rbtsco/USB2CAN/Board/render1.png

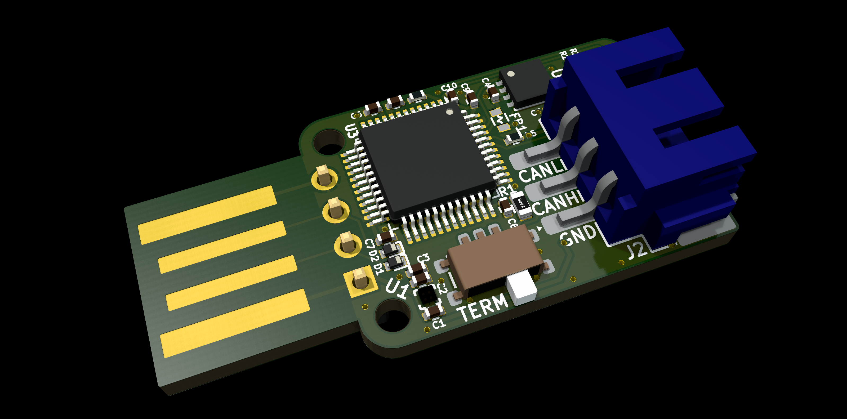
Board/render1.png
