rbtsco/USB2CAN/README.md

# USB2CAN
Tiny USB to 8Mbps Flexible-Data CAN (/ AUVCAN) adapter based on the STM32L5 and MCP2562FD
