rbtsco/USB2CAN/Board/CAM/Bottom.png

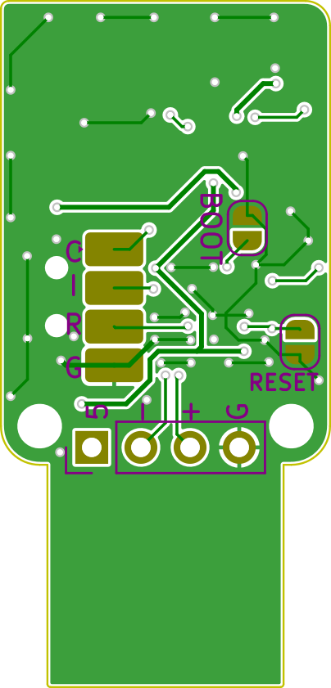
Board/CAM/Bottom.png
