rbtsco/USB2CAN/Board/CAM/Top.png

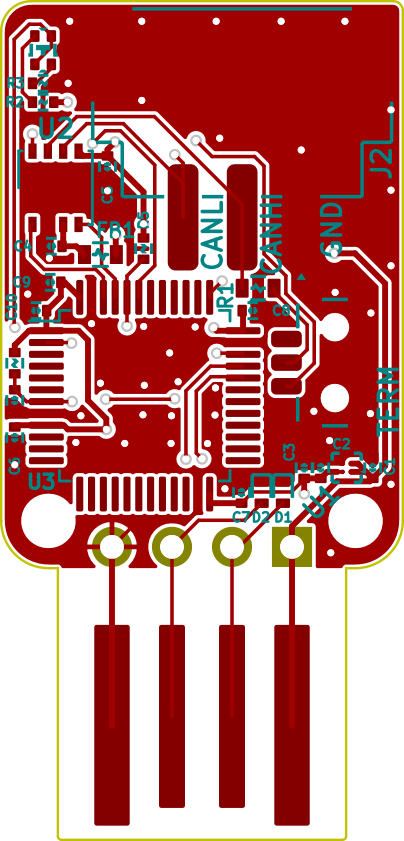
Board/CAM/Top.png
