rbtsco/USB2CAN/Board/render2.png

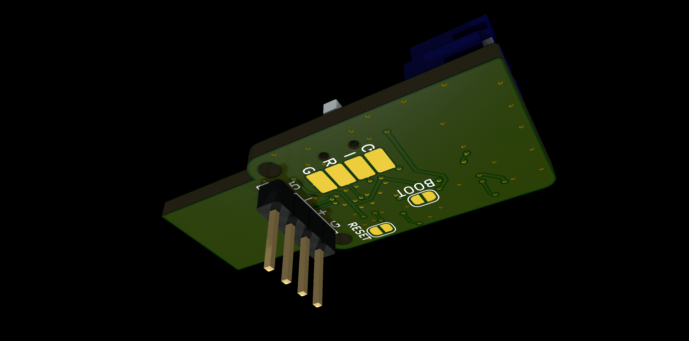
Board/render2.png
