rbtsco/USB2CAN/Board/Schematic.png

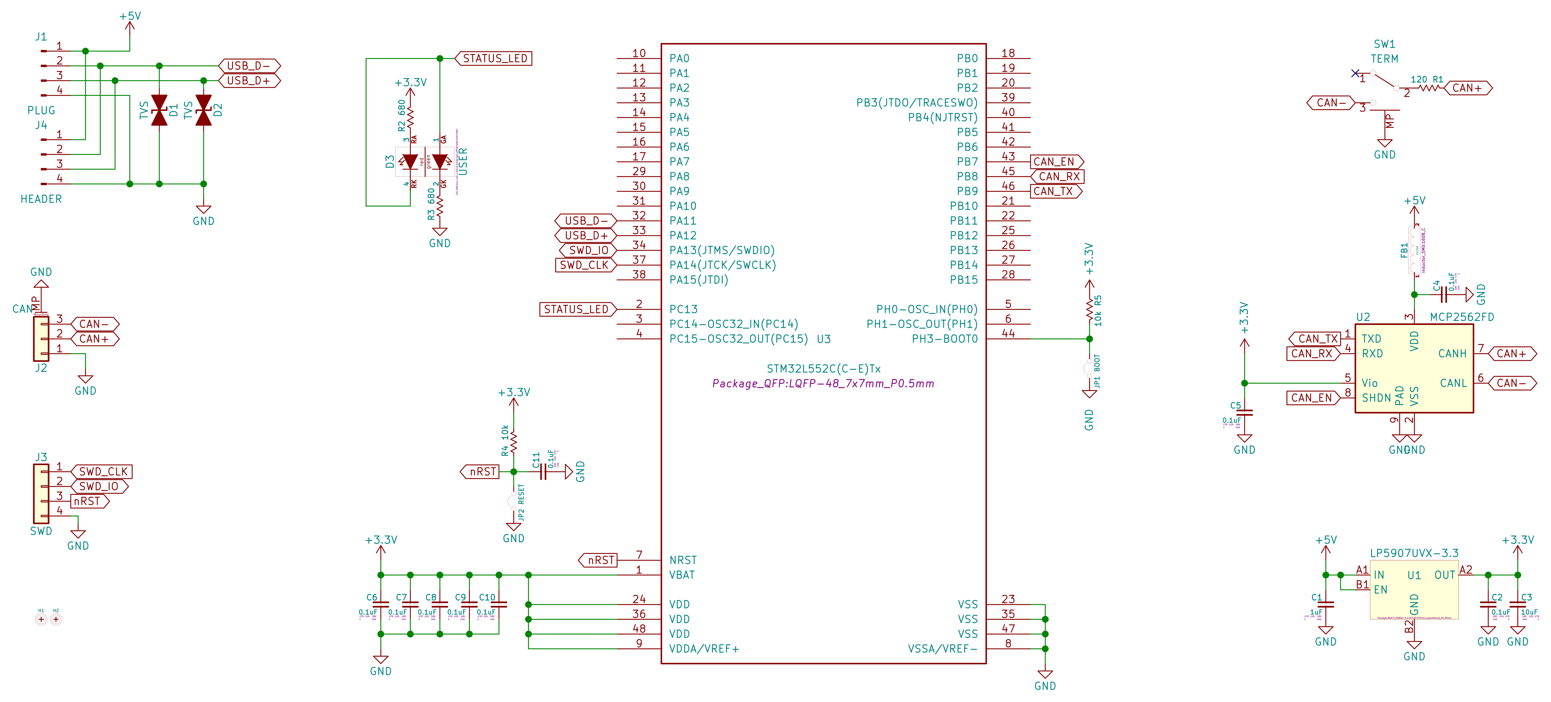
Board/Schematic.png
