rbtsco/USB2CAN/Board/USBtoCANFD.kicad_pcb

## KiCad design Board/USBtoCANFD.kicad_pcb (2021-01-06)

Schematic: USBtoCANFD.kicad_sch

Parts:
C1: 1uF; 1005_C; Voltage 10V; Tolerance 10%
C2, C4, C5, C6, C7, C8, C9, C10, C11: 0.1uF; 1005_C; Voltage 10V; Tolerance 10%
C3: 10uF; 1005_C; Voltage 10V; Tolerance 10%
D1, D2: TVS; 1006_C; MPN AR0521P1
D3: USER; Duo_LED_1.6x0.8_Kingbright_APHB1608LZGKSURKC
FB1: FILTER; 1608_C
H1, H2: Mount_Hole_Ungrounded; Plain_Hole_2mm
J1: PLUG; USB_A_PCB_traces_small
J2: CAN; JST_XH_S3B-XH-SM4-TB_1x03_P2.50mm_RightAngle
J3: SWD; 4P_3x1.75_P2.0
J4: HEADER; PinHeader_1x04_P2.54mm_Vertical
JP1: BOOT; SolderJumper-2_P1.3mm_Open_RoundedPad1.0x1.5mm
JP2: RESET; SolderJumper-2_P1.3mm_Open_RoundedPad1.0x1.5mm
R1: 120; 1608_C
R2, R3: 680; 1005_C
R4, R5: 10k; 1005_C
SW1: TERM; SPDT_Slide_HRO_K3-1293S; MPN K3-1293S
U1: LP5907UVX-3.3; TI_DSBGA-4_0.875x0.875mm_Layout2x1x2_P0.35mm; MPN LP5907UVX-3.3
U2: MCP2562FD; DFN-8-1EP_3x3mm_P0.65mm_EP1.55x2.4mm
U3: STM32L552C(C-E)Tx; LQFP-48_7x7mm_P0.5mm

Connections:
+3V3: C2.1, C3.1, C5.1, C6.1, C7.1, C8.1, C9.1, C10.1, R2.1, R4.1, R5.2, U1.A2 (OUT), U2.5 (Vio), U3.1 (VBAT), U3.9 (VDDA/VREF+), U3.24 (VDD), U3.36 (VDD), U3.48 (VDD)
+5V: C1.1, FB1.2, J1.1, J4.1, U1.A1 (IN), U1.B1 (EN)
CAN+: J2.2, R1.2, U2.7 (CANH)
CAN-: J2.3, SW1.3 (C), U2.6 (CANL)
CAN_EN: U2.8 (SHDN), U3.43 (PB7)
CAN_RX: U2.4 (RXD), U3.45 (PB8)
CAN_TX: U2.1 (TXD), U3.46 (PB9)
GND: C1.2, C2.2, C3.2, C4.2, C5.2, C6.2, C7.2, C8.2, C9.2, C10.2, C11.2, D1.1 (A1), D2.1 (A1), J1.4, J2.1, J2.MP (MountPin), J3.4, J4.4, JP1.1, JP2.1, R3.2, SW1.MP, U1.B2 (GND), U2.2 (VSS), U2.9 (PAD), U3.8 (VSSA/VREF-), U3.23 (VSS), U3.35 (VSS), U3.47 (VSS)
unnamed: C4.1, FB1.1, U2.3 (VDD)
unnamed: D3.GK (2), R3.1
unnamed: D3.RA (3), R2.2
unnamed: R1.1, SW1.2 (B)
unnamed: JP1.2, R5.1, U3.44 (PH3-BOOT0)
STATUS_LED: D3.GA (1), D3.RK (4), U3.2 (PC13)
SWD_CLK: J3.1, U3.37 (PA14(JTCK/SWCLK))
SWD_IO: J3.2, U3.34 (PA13(JTMS/SWDIO))
USB_D+: D2.2 (A2), J1.3, J4.3, U3.33 (PA12)
USB_D-: D1.2 (A2), J1.2, J4.2, U3.32 (PA11)
nRST: C11.1, J3.3, JP2.2, R4.2, U3.7 (NRST)

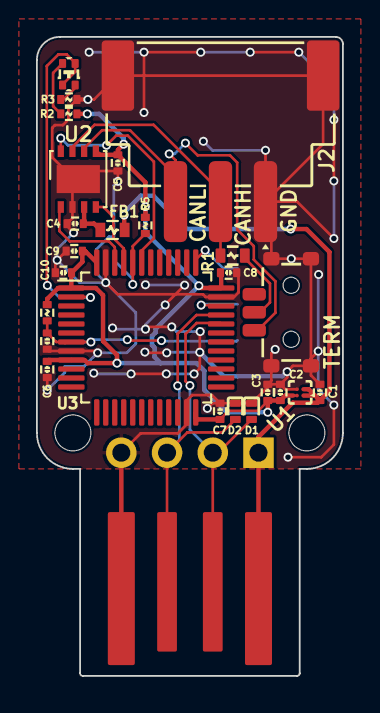
[picture p6: board USBtoCANFD.kicad_pcb from above]

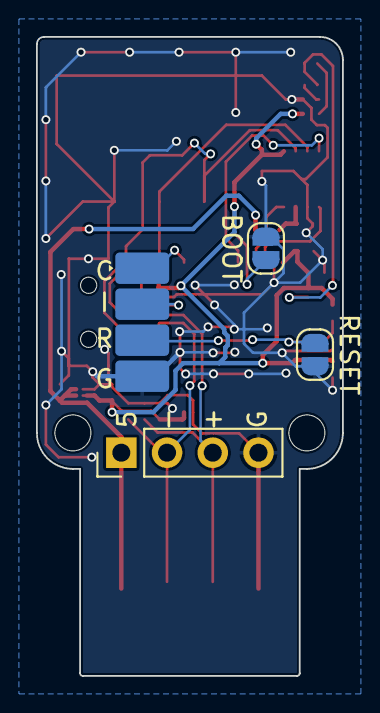
[picture p7: board USBtoCANFD.kicad_pcb from below]

Board: 2 copper layers, 17.0 x 35.5 mm, 32 parts (4 on the bottom side), 19 nets.
