rbtsco/USB2CAN/Firmware/Firmware.ioc

Mcu.UserName=STM32L552CCTx
PA11.Signal=USB_DM
PA12.Signal=USB_DP
PB7.GPIO_Label=CAN_EN
PB7.Signal=GPIO_Output
PB8.Signal=FDCAN1_RX
PB9.Signal=FDCAN1_TX
PC13.GPIO_Label=STATUS_LED
PC13.Signal=GPIO_Output
