rbtsco/USB2CAN/(commit log)

2021-01-06 Initial version
    [USBtoCANFD-B_Cu.gbr, USBtoCANFD-B_Mask.gbr, USBtoCANFD-B_Paste.gbr, USBtoCANFD-B_Silkscreen.gbr, USBtoCANFD-Edge_Cuts.gbr, USBtoCANFD-F_Cu.gbr, USBtoCANFD-F_Mask.gbr, USBtoCANFD-F_Paste.gbr]
2021-01-06 Manually configure clocks to not run into MSI issue
    [Firmware.ioc]
